eren-rudy/audio-power-amplifier/notes.txt.txt

tweeter_final_shematic.png
- replace Ri for woofer for different gain
- Include Cc and the HP filter in the feedback loop as nostuff components
