eren-rudy/audio-power-amplifier/tweeter_final_schematic.JPG

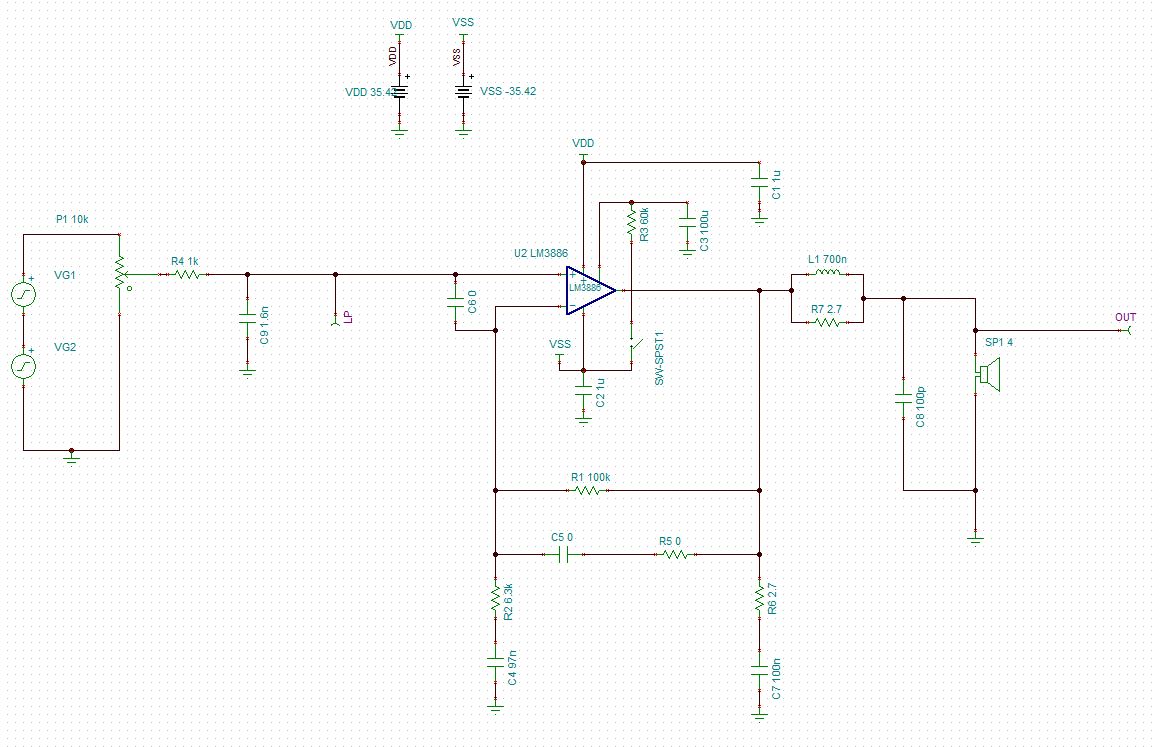
tweeter_final_schematic.JPG
