eren-rudy/audio-power-amplifier/bom_panel.xlsx

Item | MPN | DPN | Quantity | Description | Notes
Panel IO
AUX Connector
Potentiometer | EVU-F3MFL3D14 | P3F6103-ND | 3 | 10k Ohm 1 Gang Logarithmic Panel Mount Potentiometer Detent 1 Kierros 0.05W, 1/20W PC Pins, Board Locks
Power Receptacle | KM01.1205.11 | 486-2280-ND |  | Power Entry Connector Receptacle, Male Blades - Module IEC 320-C14 Panel Mount, Snap-In | 7/30 strands
Fuse
 |  |  |  |  | 4.8 mm Quick Connect
Harness |  |  |  |  | will use insulated quick connect
Audio Input wire | E2102S.41.02 | CE2102W-25-ND | 1 | 2 Conductor Multi-Conductor Cable White 22 AWG Foil 25.00' (7.62m)
Quick Connect - Female (power input) | 3-520276-2 (https://www.digikey.ca/en/products/detail/te-connectivity-amp-connectors/3-520276-2/2060928) | A99878CT-ND |  | 0.187" (4.75mm) Quick Connect Female 14-16 AWG Crimp Connector Fully Insulated | 0.8 mm thick
Quick Connect - Female (power distribution) | 4-520448-2 | A27831-ND |  | 0.250" (6.35mm) Quick Connect Female 10-12 AWG Crimp Connector Fully Insulated | 0.8mm
Ring terminals
Quick Connect - Male (power) | 1217861-1 | A100452CT-ND | 12 | 0.250" (6.35mm) Quick Connect Male Solder Connector Non-Insulated | 0.8mm
Power Distribution wire
Black | 22759/32-12-0 | 22759/32-12-0-DS-ND |  | 12 AWG Hook-Up Wire 37/28 Black 600V Enter Number of Feet in Order Quantity
White | 81044/12-12-9 | A132407-DS-ND |  | 12 AWG Hook-Up, Dual Wall Wire 37/28 White 600V Enter Number of Feet in Order Quantity
Brown | 55A0111-12-1 | 55A0111-12-1-DS-ND |  | 12 AWG Hook-Up Wire 37/28 Brown 600V Enter Number of Feet in Order Quantity
Primary side splice | 8383 | 36-8383-ND | 2 | Terminal Inline, Tap Connector IDC 14-16 to 18-20 AWG Blue
Primary side wire | 55A0111-14-9 | A132382-DS-ND |  | 14 AWG Hook-Up Wire 19/27 White 600V Enter Number of Feet in Order Quantity
Power supply
Diode heat sink | V5220L | AE10828-ND | 2 | Heat Sink TO-220 Aluminum Board Level
Misc
Standoffs
Crimping tool | CT-4071-1R (https://www.digikey.ca/en/products/detail/gc-electronics/CT-4071-1R/6616089) | CT-4071-1R-ND
heat shrink (Audio input) | V2-1.5-0-SP-SM | V2-1.5-R5-ND | 1 | Heat Shrink Tubing, Flexible 0.083" (2.11mm) 2 to 1 Black 0.042' (12.70mm, 0.50")
