eren-rudy/audio-power-amplifier/board_files/Prototype Board/Project Outputs for LM3886 Amplifier Prototype/Prototype Board V1.xlsx

Supplier Part Number 1 | Description | Designator | LibRef | Quantity
493-3209-1-ND (https://octopart-clicks.com/click/altium?sku=493-3209-1-ND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) | CAP ALUM 100UF 20% 50V SMD | C1, C4, C7 | UUQ1H101MCL1GS | 3
PCF1561CT-ND (https://octopart-clicks.com/click/altium?manufacturer=Panasonic%20Electronic%20Components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) | CAP FILM 0.1UF 5% 50VDC 1913 | C2, C5 | ECH-U1H104JX9 | 2
445-7513-1-ND (https://octopart-clicks.com/click/altium?manufacturer=TDK%20Corporation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) | CAP CER 5600PF 50V C0G 0805 | C3 | C2012C0G1H562J060AA | 1
399-14632-1-ND (https://octopart-clicks.com/click/altium?sku=399-14632-1-ND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) | CAP CER 75PF 50V NP0 0805 | C6 | C0805C750J5GAC7800 | 1
CP-3523SJCT-ND (https://octopart-clicks.com/click/altium?sku=CP-3523SJCT-ND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) | CONN JACK STEREO 3.5MM SMD R/A | J1 | SJ-3523-SMT-TR | 1
2100LL-100-V-RC-ND (https://octopart-clicks.com/click/altium?sku=2100LL-100-V-RC-ND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) | FIXED IND 10UH 11.4A 5 MOHM TH | L1 | 2100LL-100-V-RC | 1
311-6.34KDCT-ND (https://octopart-clicks.com/click/altium?sku=311-6.34KDCT-ND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) | RES SMD 6.34KOHM 0.5% 1/10W 0603 | R1 | RT0603DRD076K34L | 1
YAG2327CT-ND (https://octopart-clicks.com/click/altium?sku=YAG2327CT-ND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) | RES SMD 10K OHM 0.1% 1/8W 0805 | R2 | RT0805BRE0710KL | 1
P100KDACT-ND (https://octopart-clicks.com/click/altium?manufacturer=Panasonic%20Electronic%20Components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) | RES SMD 100K OHM 0.1% 1/8W 0805 | R3 | ERA-6AEB104V | 1
PDB181-K420K-103B-ND | POT 10K OHM 1/5W CARBON LINEAR | R4 | PDB181-K420K-103B | 1
YAG1240CT-ND (https://octopart-clicks.com/click/altium?sku=YAG1240CT-ND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) | RES SMD 1K OHM 1% 1/8W 0805 | R5 | RT0805FRE071KL | 1
RNCP0805FTD10R0CT-ND (https://octopart-clicks.com/click/altium?manufacturer=Stackpole%20Electronics%20Inc.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) | RES 10 OHM 1% 1/4W 0805 | R6 | RNCP0805FTD10R0 | 1
311-2737-1-ND (https://octopart-clicks.com/click/altium?sku=311-2737-1-ND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) | RES SMD 34.8K OHM 0.5% 1/8W 0805 | R7 | RT0805DRD0734K8L | 1
LM3886TF/NOPB-ND | IC AMP AUDIO PWR 68W AB TO220-11 | U1 | LM3886TF | 1
