eren-rudy/audio-power-amplifier/(list of files, cad)

Other CAD files:
Cabinet Sketch.SLDPRT
