eren-rudy/audio-power-amplifier/Testing.xlsx

Sheet: Validation
Validation Parameter (Dependant variable)
 | Units | Independent Variable | Units | Value | Expected Value | Measured Value
Speaker Output Voltage | Volts | Input Frequency |  | 1kHz
 |  |  |  | 5kHz
 |  |  |  | 10kHz
Speaker Output Voltage | Volts | Potentiometer position |  | 0%
 |  |  |  | 100%
Speaker Loudness | dB | Input Frequency |  | 1kHz
 |  |  |  | 5kHz
 |  |  |  | 10kHz
Mute loudness | Observed sound or none | Mute pin connection | Open/Closed | Open | None

Sheet: Waveforms
Variable | Units | Value | Notes | Waveform Number
Speaker Wire Length | Feet | 0 | Remove Inductor
 |  | 1
 |  | 3
 |  | 6
Output Inductance | Micro-Henries | 0
 |  | 10
Potentiometer Resistance | % | 0
 |  | 50
 |  | 100
Potentiometer Wire Length | Inches | 3
 |  | 12
