eren-rudy/audio-power-amplifier/sims/sim_results/0_circuit.PNG

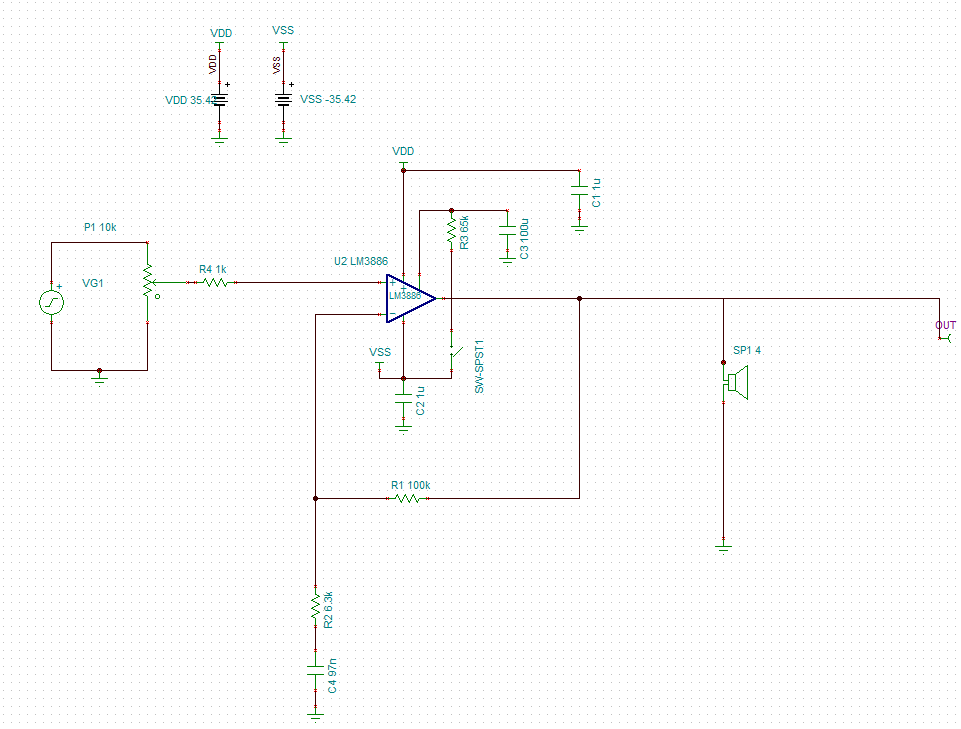
sims/sim_results/0_circuit.PNG
