eren-rudy/audio-power-amplifier/sims/sim_results/0_pm.jpg

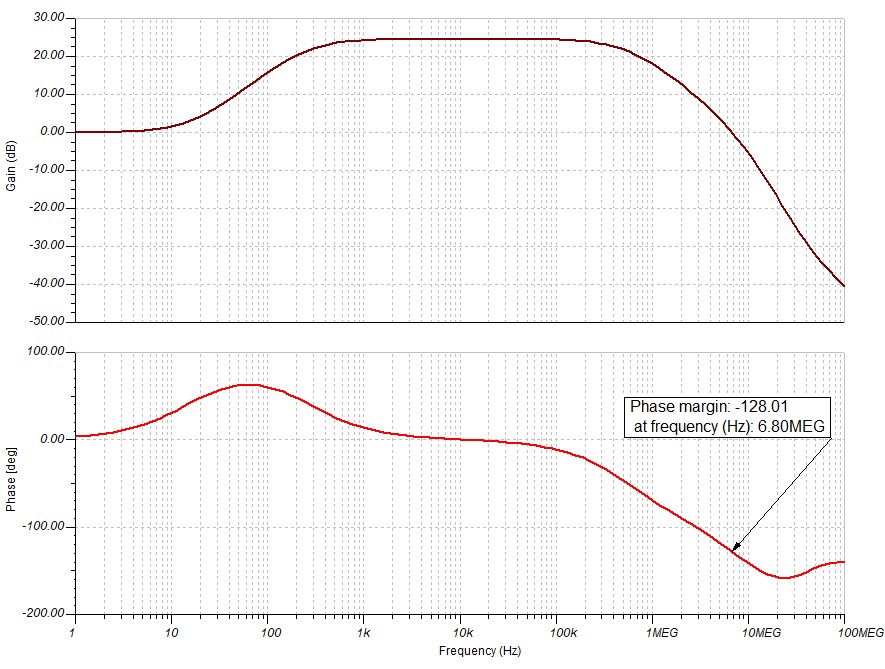
sims/sim_results/0_pm.jpg
