eren-rudy/audio-power-amplifier/sims/sim_results/1_C_only_pm.jpg

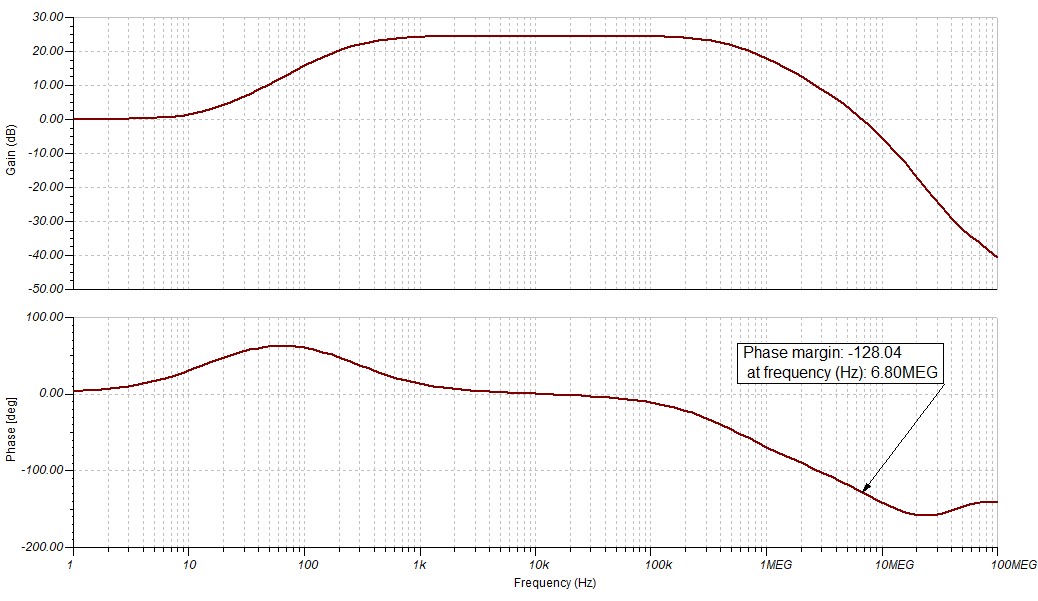
sims/sim_results/1_C_only_pm.jpg
