eren-rudy/audio-power-amplifier/sims/sim_results/1_L+C_circuit.PNG

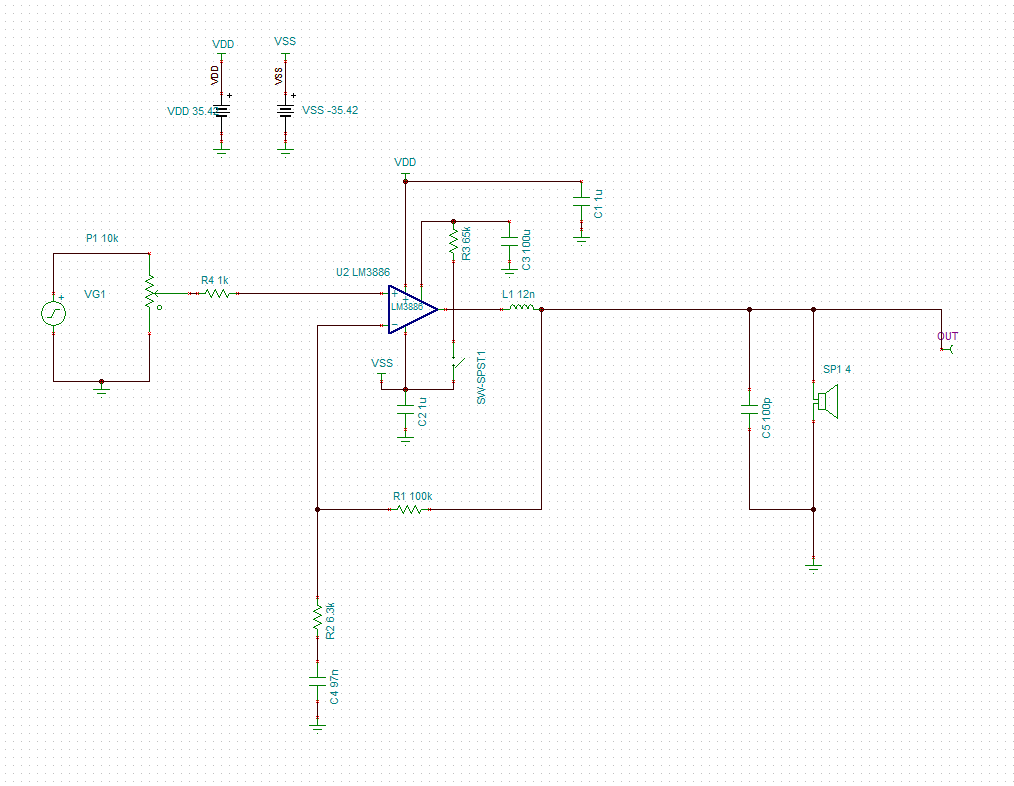
sims/sim_results/1_L+C_circuit.PNG
