eren-rudy/audio-power-amplifier/sims/sim_results/1_L+C_pm_gm.jpg

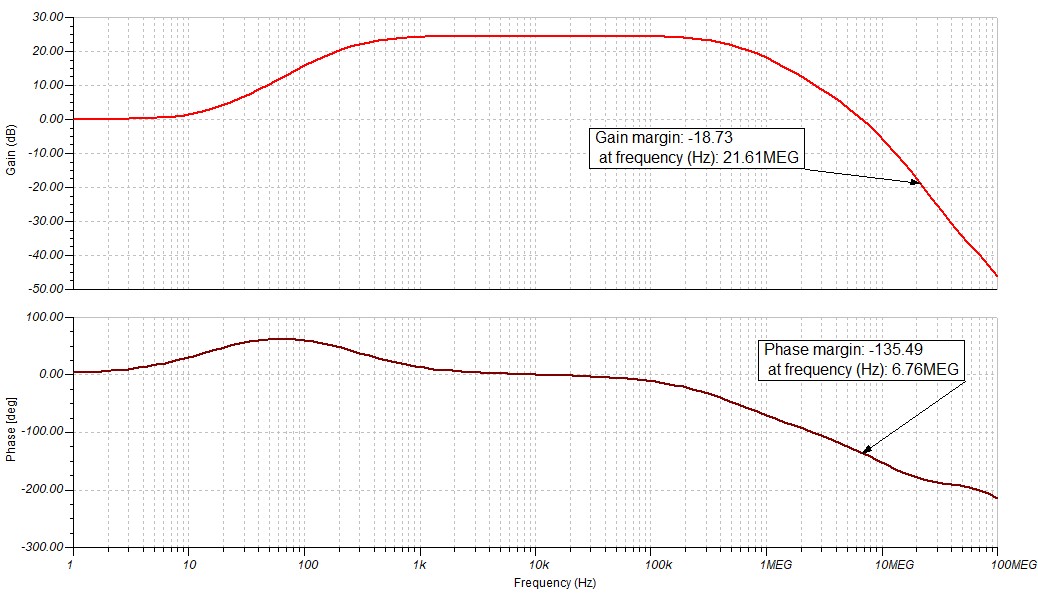
sims/sim_results/1_L+C_pm_gm.jpg
