eren-rudy/audio-power-amplifier/sims/sim_results/1_L_only_circuit.PNG

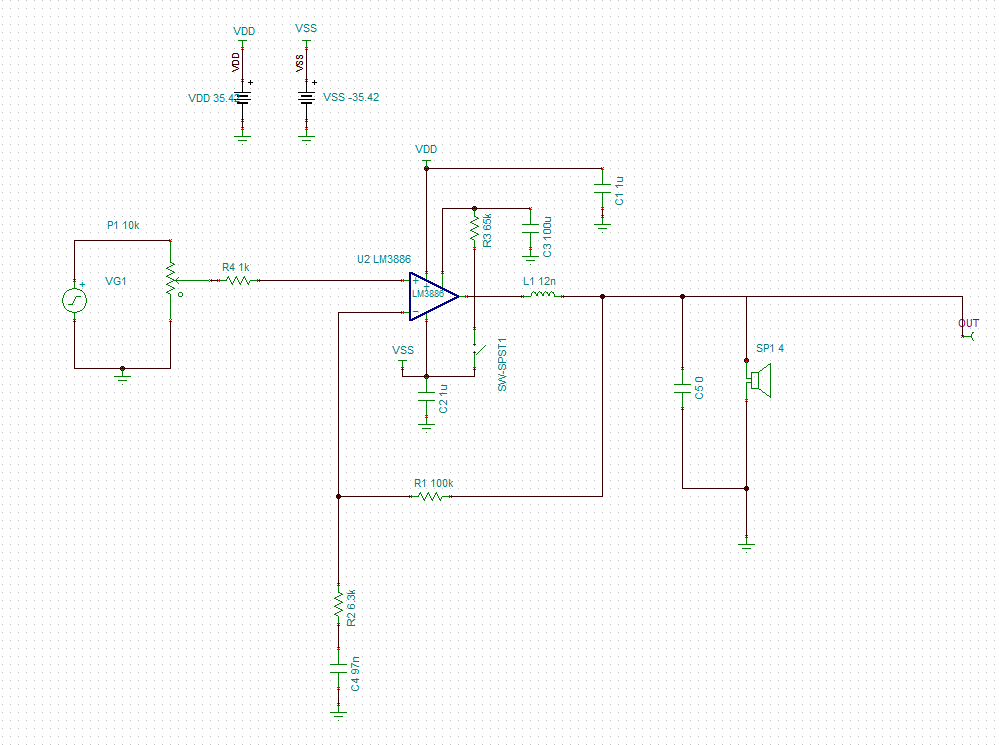
sims/sim_results/1_L_only_circuit.PNG
