eren-rudy/audio-power-amplifier/sims/sim_results/1_L_only_pm.jpg

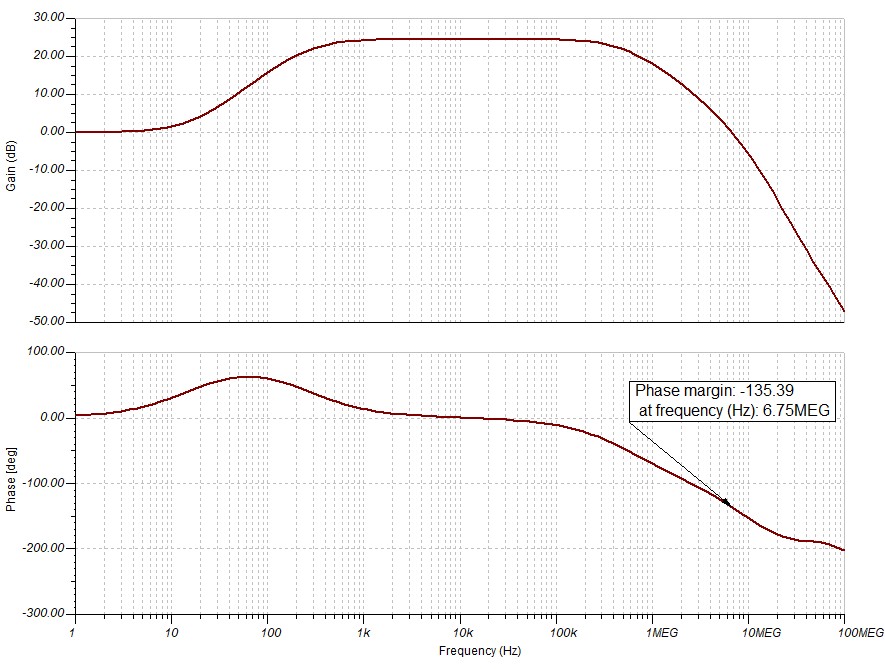
sims/sim_results/1_L_only_pm.jpg
