eren-rudy/audio-power-amplifier/sims/sim_results/2_parasitics_w_thiele_circuit.PNG

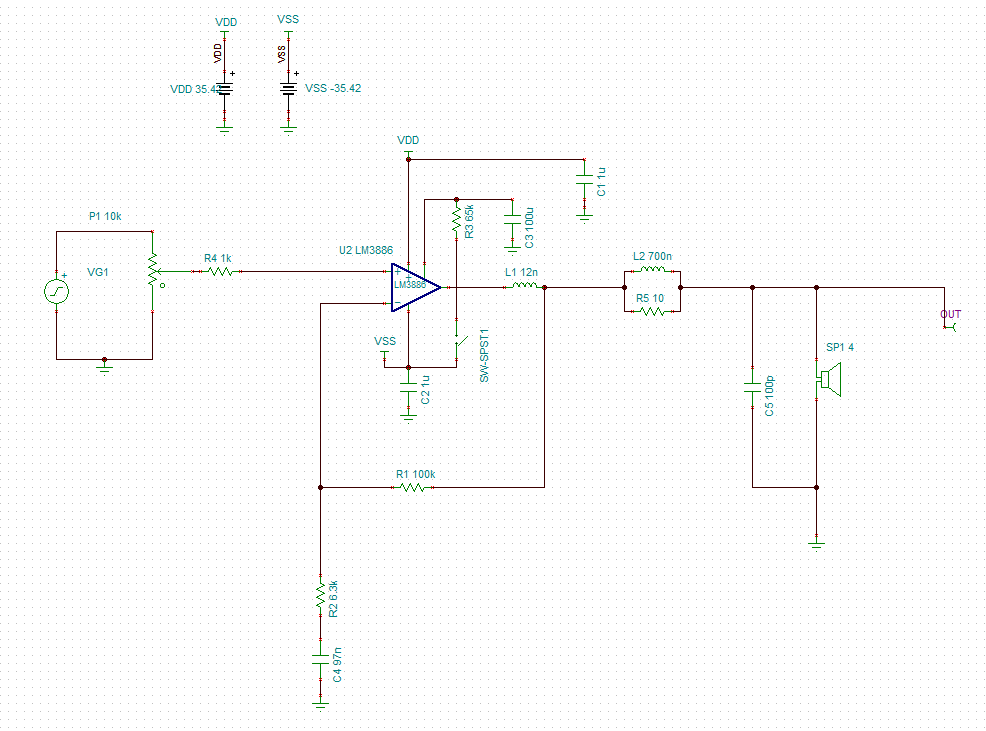
sims/sim_results/2_parasitics_w_thiele_circuit.PNG
