eren-rudy/audio-power-amplifier/sims/sim_results/2_parasitics_w_thiele_pm_gm.jpg

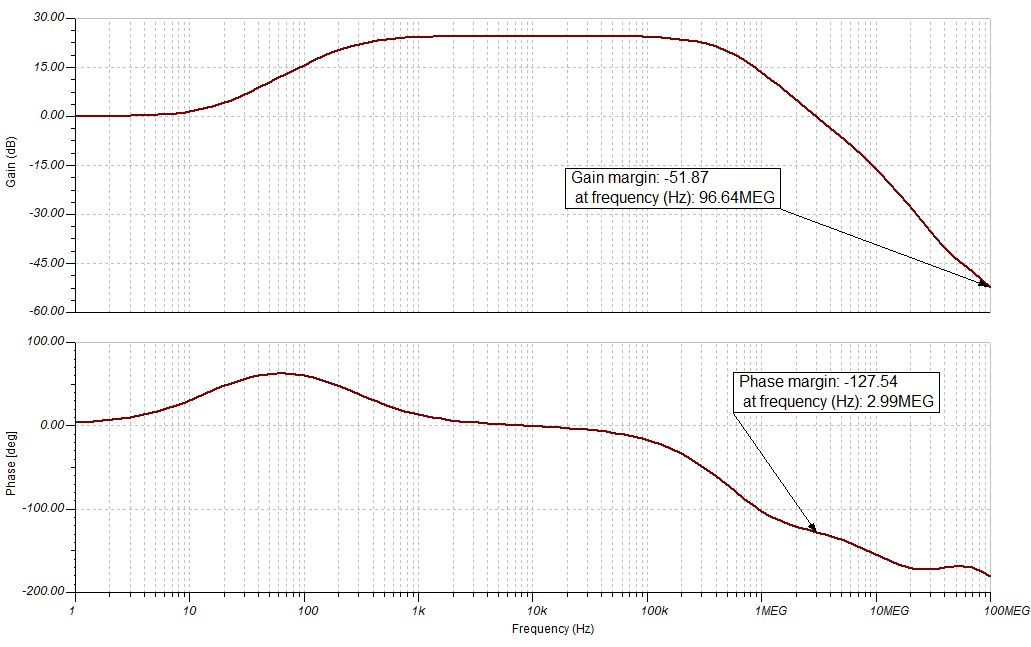
sims/sim_results/2_parasitics_w_thiele_pm_gm.jpg
