eren-rudy/audio-power-amplifier/sims/sim_results/3_parasitics_w_zobel_circuit.PNG

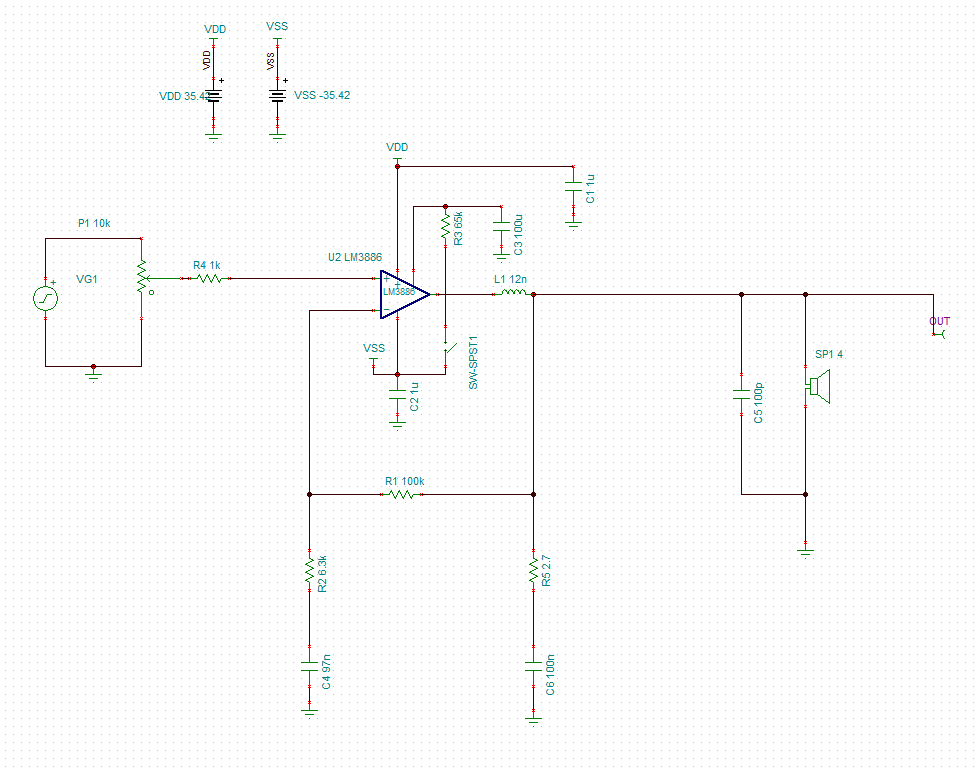
sims/sim_results/3_parasitics_w_zobel_circuit.PNG
