eren-rudy/audio-power-amplifier/sims/sim_results/3_parasitics_w_zobel_pm_gm.jpg

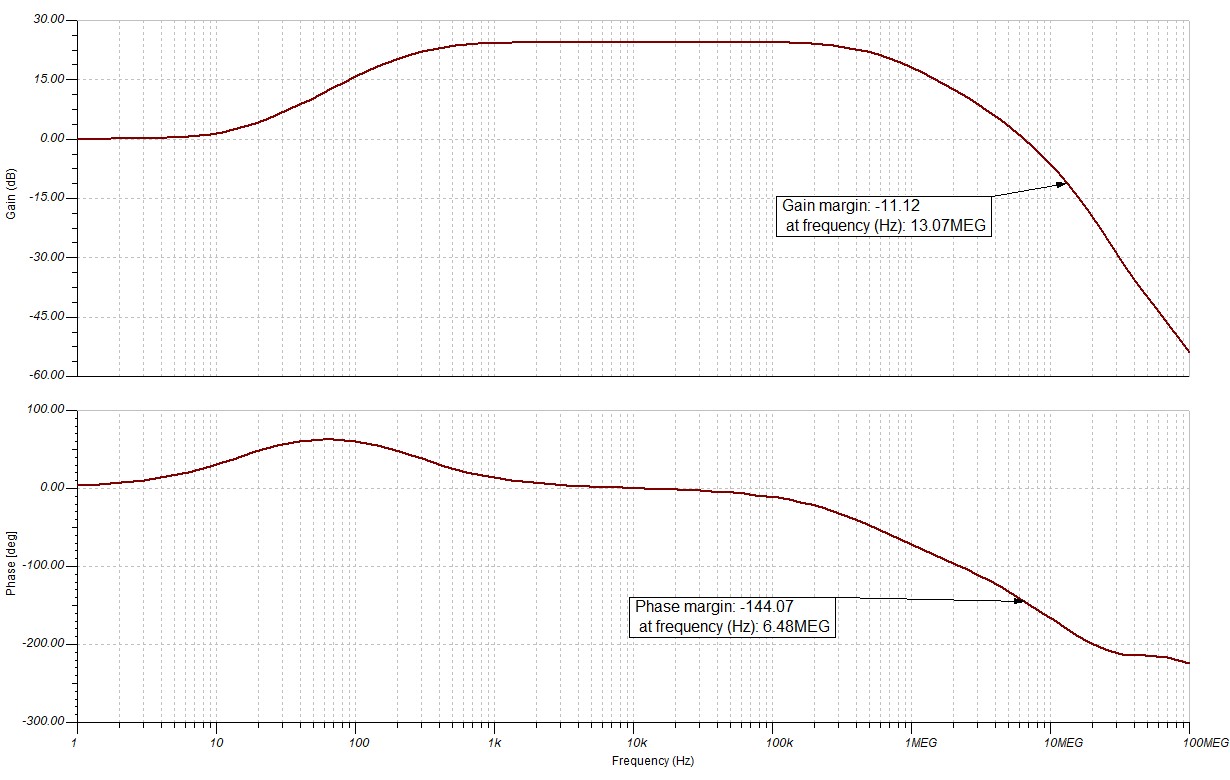
sims/sim_results/3_parasitics_w_zobel_pm_gm.jpg
