eren-rudy/audio-power-amplifier/sims/sim_results/4_parasitics_w_zobel+thiele_circuit.PNG

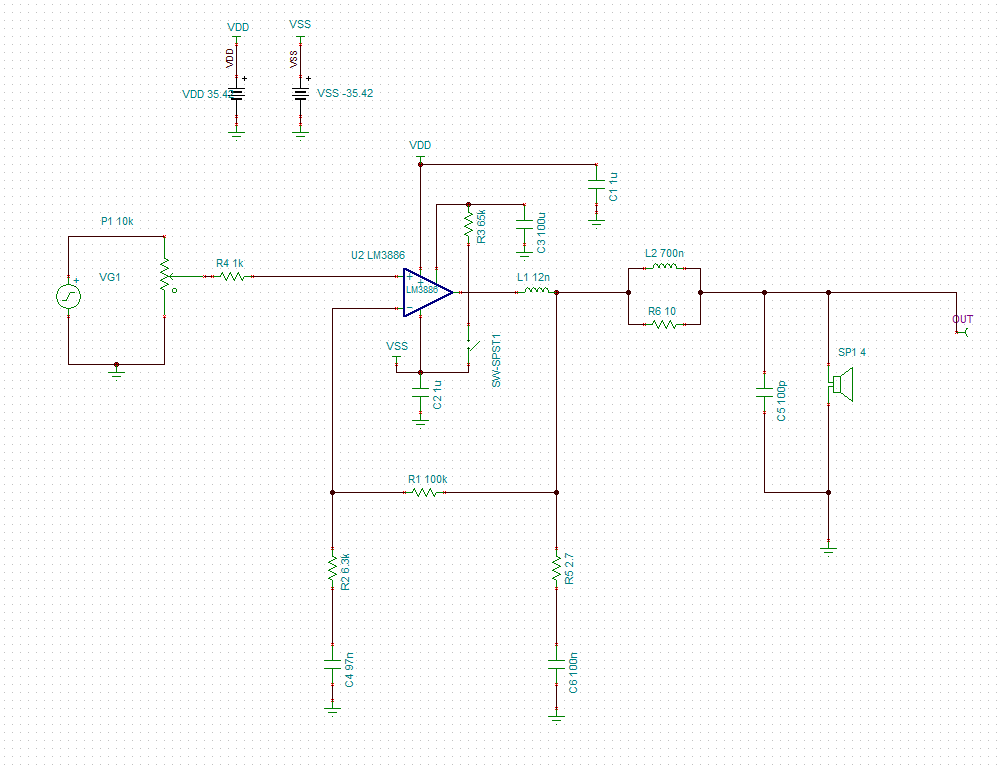
sims/sim_results/4_parasitics_w_zobel+thiele_circuit.PNG
