eren-rudy/audio-power-amplifier/sims/sim_results/4_parasitics_w_zobel+thiele_pm_gm.jpg

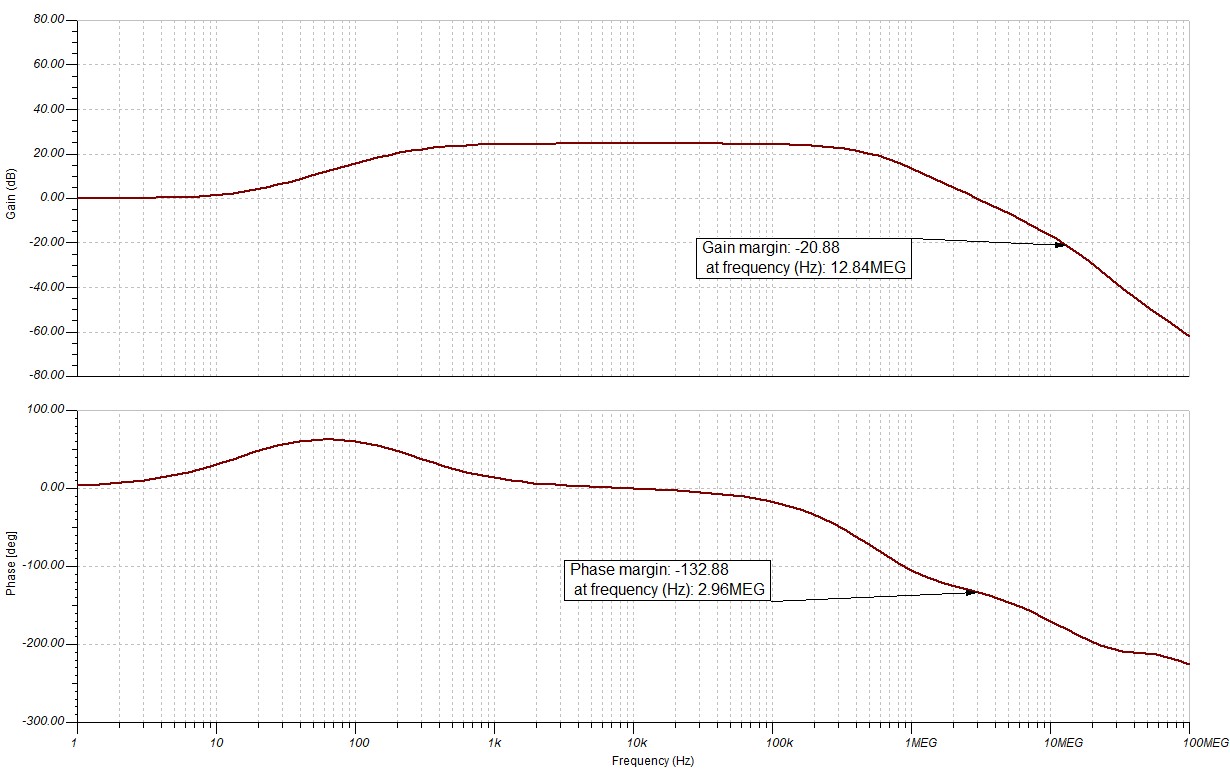
sims/sim_results/4_parasitics_w_zobel+thiele_pm_gm.jpg
