eren-rudy/audio-power-amplifier/board_files/Prototype Board/Prototype Schematic.pdf

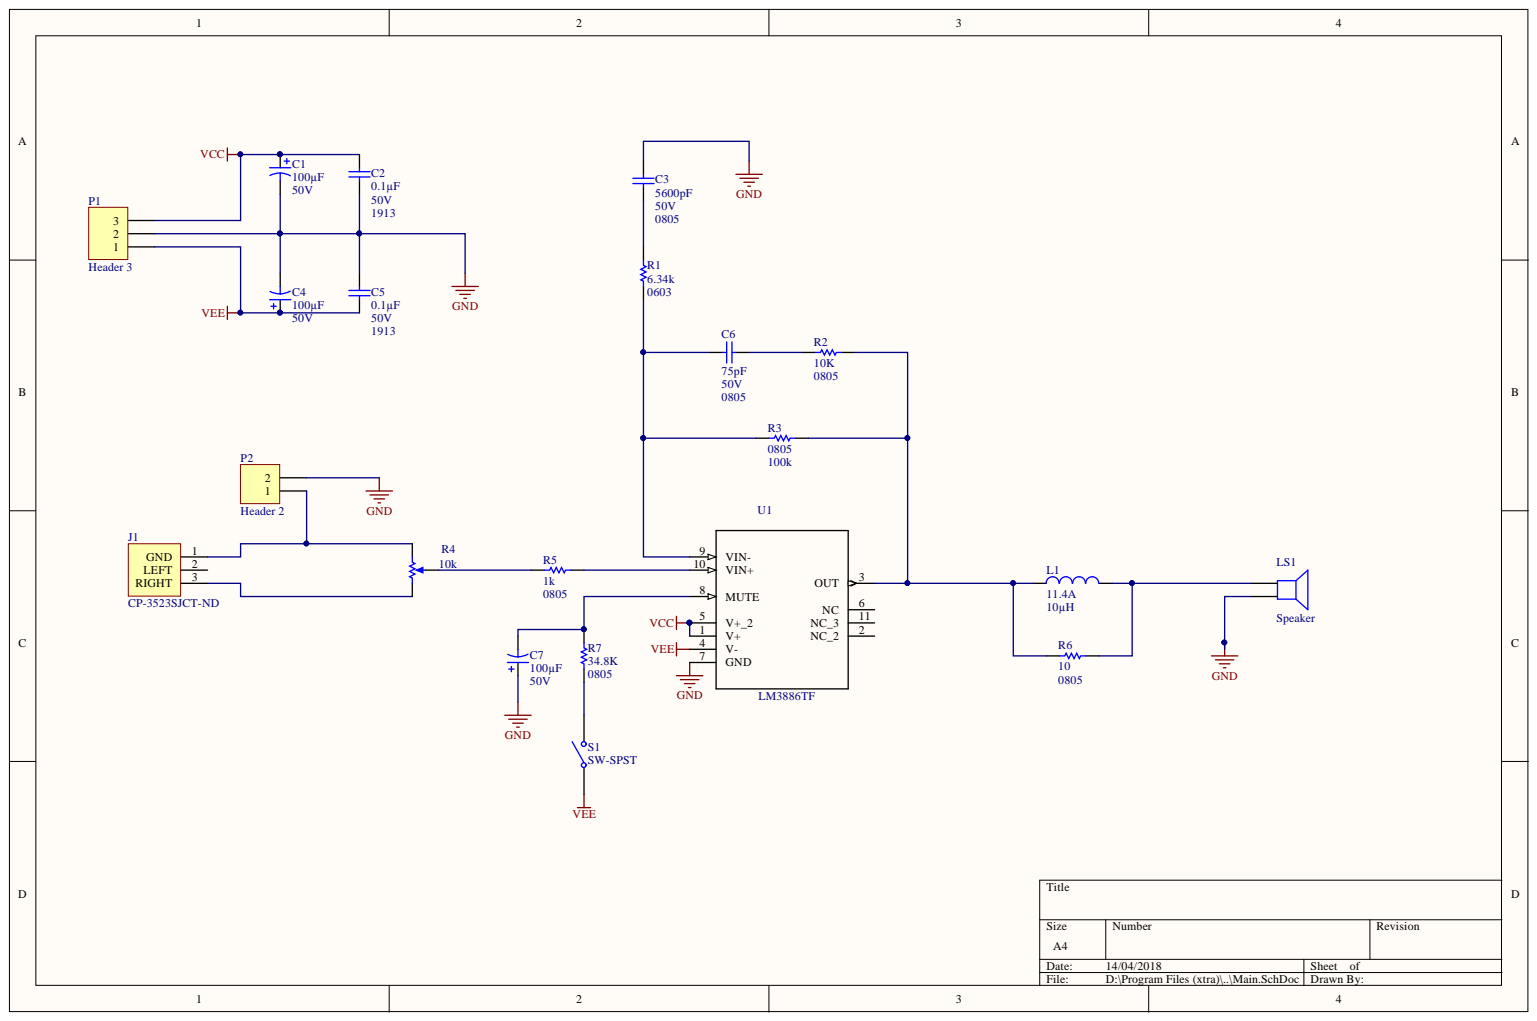
[picture p16: page 1]
