eren-rudy/audio-power-amplifier/board_files/Prototype Board/Prototype Layout.pdf

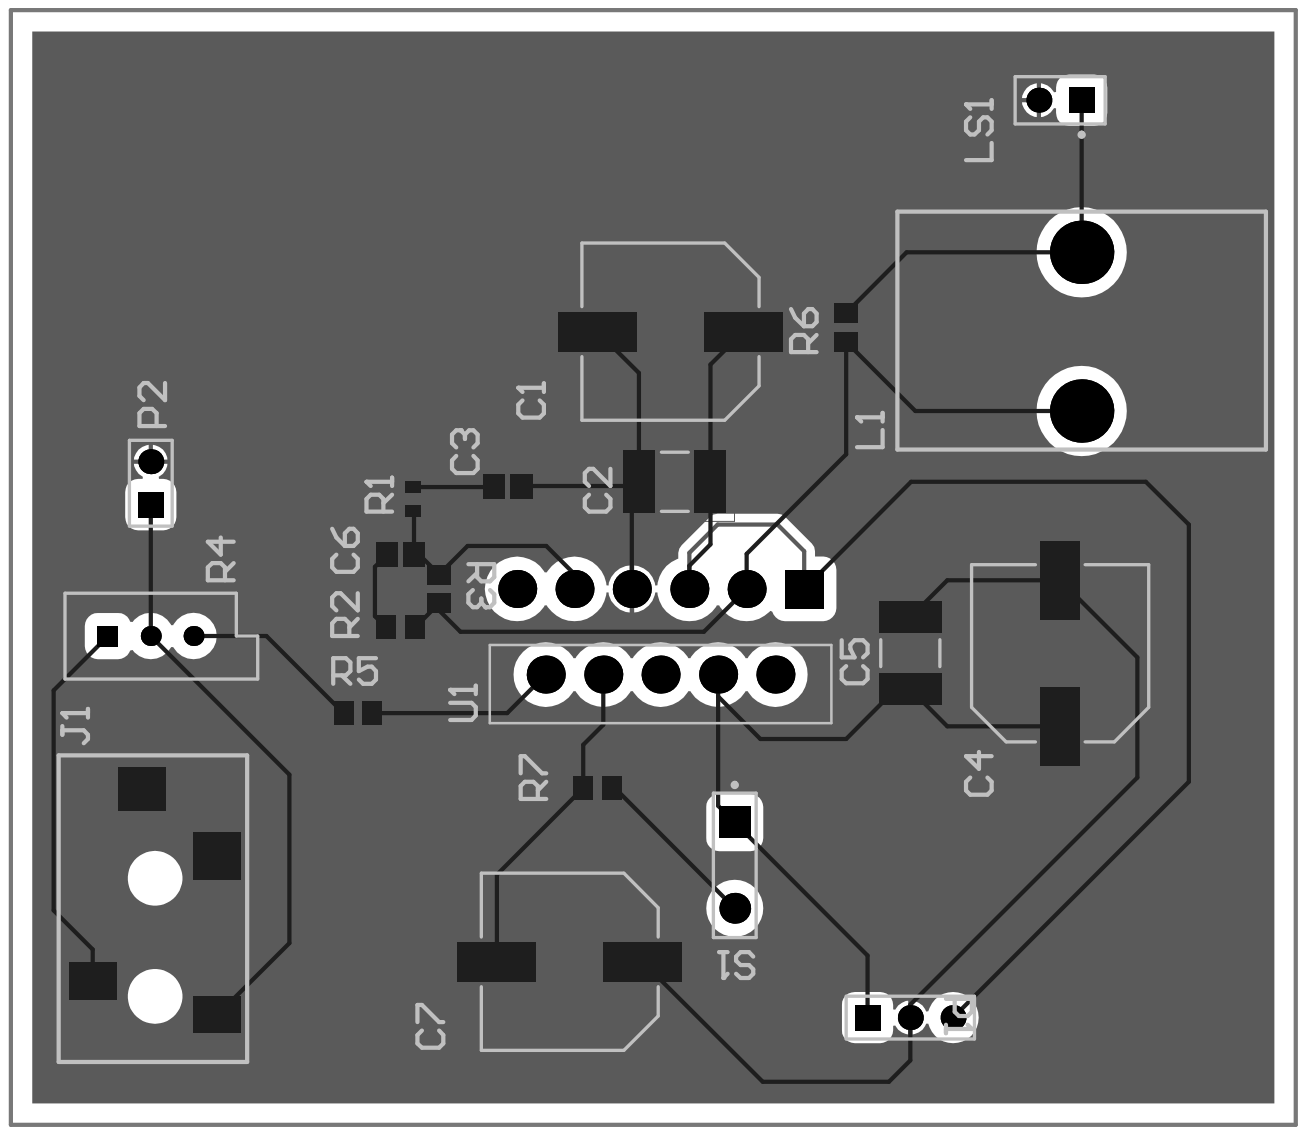
[picture p17: page 1]
