eren-rudy/audio-power-amplifier/sims/power_supply/psu_single_rectifier.asc

C1: cap; 1
C2: cap; 1
D1: diode
D2: diode
D3: diode
D4: diode
I1: current; 20
L1: ind2; 23.8; Rser=0
L2: ind2; 1; Rser=0
L3: ind2; 1; Rser=0
R1: res; 0.34
R2: res; 0.04
R3: res; 0.04
R4: res; 1Meg
R5: res; 1Meg
V1: voltage; SINE(0 169.7 60); Rser=0
Named nets: 0, V+, V-, V2
K1 L1 L2 L3 1
.tran 1
