eren-rudy/audio-power-amplifier/sims/power_supply/psu_centre_tap_gnd.asc

C1: cap; 1
C2: cap; 1
D1: diode
D2: diode
D3: diode
D4: diode
I1: current; 1
L1: ind2; 23.8; Rser=0
L2: ind2; 1; Rser=0
L3: ind2; 1; Rser=0
R1: res; 0.34
R2: res; 0.04
R3: res; 0.04
V1: voltage; SINE(0 169.7 60); Rser=0
Named nets: 0, V+, V2, V-
K1 L1 L2 L3 1
.tran 1
