eren-rudy/audio-power-amplifier/sims/power_supply/psu_wrong.asc

C1: cap; 1
C2: cap; 1
D1: diode
D2: diode
D3: diode
D4: diode
D5: diode
D6: diode
D7: diode
D8: diode
I1: load; 20
L1: ind2; 23.8; Rser=0.0001
L2: ind2; 1; Rser=0.0001
L3: ind2; 1; Rser=0.0001
V1: voltage; SINE(0 169.7 60); Rser=0
Named nets: 0, V+, V-, V2
K1 L1 L2 L3 1
.tran 2
