eren-rudy/audio-power-amplifier/sims/power_supply/transformer_resonant_circuit.asc

C1: cap; 1µ
I1: current; PULSE(10A 0 0.1 0 1n 0 0.1 3)
L3: ind; 1m
R1: res; 1
V1: voltage; 170; Rser=0
Named nets: 0
.tran 0.5
