eren-rudy/audio-power-amplifier/(list of files, drawings)

Other design files:
board_files/4 Channel Power Amplifier/4 Channel Power Amplifier.PrjPcb
board_files/4 Channel Power Amplifier/Tweeter Right.SchDoc
board_files/Integrated_Libraries/Aluminum Electrolytic Caps.PcbLib
board_files/Integrated_Libraries/Capacitors.SchLib
board_files/Integrated_Libraries/Chip Footprints.PcbLib
board_files/Integrated_Libraries/Inductors.PcbLib
board_files/Integrated_Libraries/Inductors.SchLib
board_files/Integrated_Libraries/Mechanical_Devices.PcbLib
board_files/Integrated_Libraries/Mechanical_Devices.SchLib
board_files/Integrated_Libraries/Resistors.SchLib
board_files/LM3886TF/Imported LM3886TF.lia/LM3886TF.PcbLib
board_files/LM3886TF/Imported LM3886TF.lia/LM3886TF.SchLib
board_files/Prototype Board/LM3886 Amplifier Prototype.PrjPcb
board_files/Prototype Board/Main.SchDoc
board_files/Prototype Board/Prototype Board V1.PcbDoc
