eren-rudy/audio-power-amplifier/board_files/power_supply/power_supply.kicad_pcb

## KiCad design board_files/power_supply/power_supply.kicad_pcb (2020-07-10)

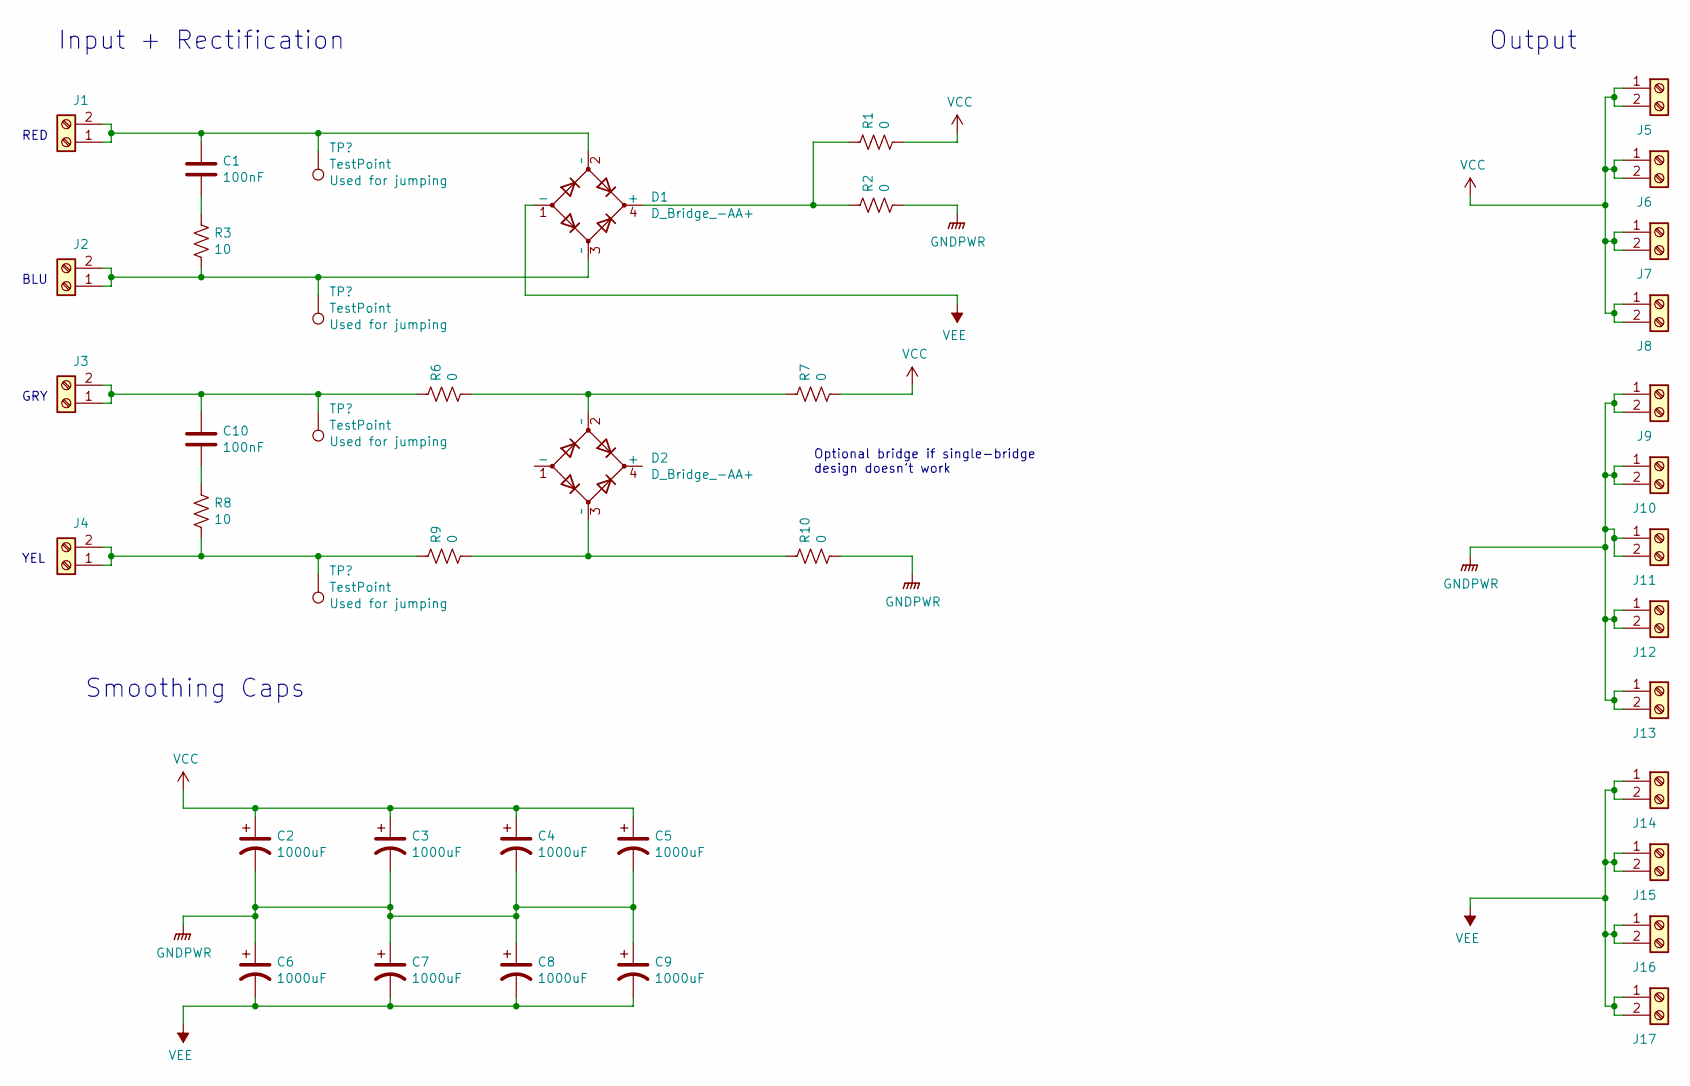
[picture p18: schematic power_supply.sch]

Parts:
C1, C10: 100nF; C_1206_3216Metric; MPN 885012208118; Digikey PN 732-12245-1-ND
C2, C3, C4, C5, C6, C7, C8, C9: 1000uF; CP_Radial_D12.5mm_P5.00mm; MPN ECA-1HM102B; Digikey PN P19529CT-ND
D1, D2: D_Bridge_-AA+; Diode_Bridge_32.0x5.6x17.0mm_P10.0mm_P7.5mm; MPN GBJ2508-BP; Digikey PN GBJ2508-BPMS-ND
J1, J2, J3, J4, J5, J6, J7, J8, J9, J10, J11, J12, J13, J14, J15, J16, J17: Screw_Terminal_01x02; TE_QC_250_Male_Blade_P5.08; MPN 1217861-1; Digikey PN A100452CT-ND
R1, R2, R6, R7, R9, R10: 0; 12_Gauge_Jumper
R3, R8: 10; R_Axial_DIN0207_L6.3mm_D2.5mm_P7.62mm_Horizontal; MPN FMP100JR-52-10R; Digikey PN 10WCT-ND

Connections:
GNDPWR: C2.2, C3.2, C4.2, C5.2, C6.1, C7.1, C8.1, C9.1, J9.1, J9.2, J10.1, J10.2, J11.1, J11.2, J12.1, J12.2, J13.1, J13.2, R2.2, R10.2
unnamed 1: C1.1, D1.2 (~~), J1.1, J1.2; also elsewhere on the board
unnamed: C1.2, R3.1
unnamed 3: C10.1, J3.1, J3.2, R6.1; also elsewhere on the board
unnamed: C10.2, R8.1
unnamed 5: D1.3 (~~), J2.1, J2.2, R3.2; also elsewhere on the board
unnamed: D1.4 (+), R1.1, R2.1
unnamed: D2.2 (~~), R6.2, R7.1
unnamed: D2.3 (~~), R9.2, R10.1
unnamed 11: J4.1, J4.2, R8.2, R9.1; also elsewhere on the board
VCC: C2.1, C3.1, C4.1, C5.1, J5.1, J5.2, J6.1, J6.2, J7.1, J7.2, J8.1, J8.2, R1.2, R7.2
VEE: C6.2, C7.2, C8.2, C9.2, D1.1 (-), J14.1, J14.2, J15.1, J15.2, J16.1, J16.2, J17.1, J17.2

Notes on the sheet:
RED
BLU
GRY
YEL
Optional bridge if single-bridge design doesn’t work
Input + Rectification
Smoothing Caps
Output

Board: 2 copper layers, 41 parts (0 on the bottom side), 12 nets, no tracks yet.

Other parts of the board:
TP1, TP2, TP3, TP4: TestPoint; 12_Gauge_Jumper_one_pad

Their connections:
unnamed 1: TP1.1; also elsewhere on the board
unnamed 3: TP3.1; also elsewhere on the board
unnamed 5: TP2.1; also elsewhere on the board
unnamed 11: TP4.1; also elsewhere on the board
