eren-rudy/audio-power-amplifier/board_files/one_channel_amplifier/one_channel_amplifier.kicad_pcb

## KiCad design board_files/one_channel_amplifier/one_channel_amplifier.kicad_pcb (2020-07-05)

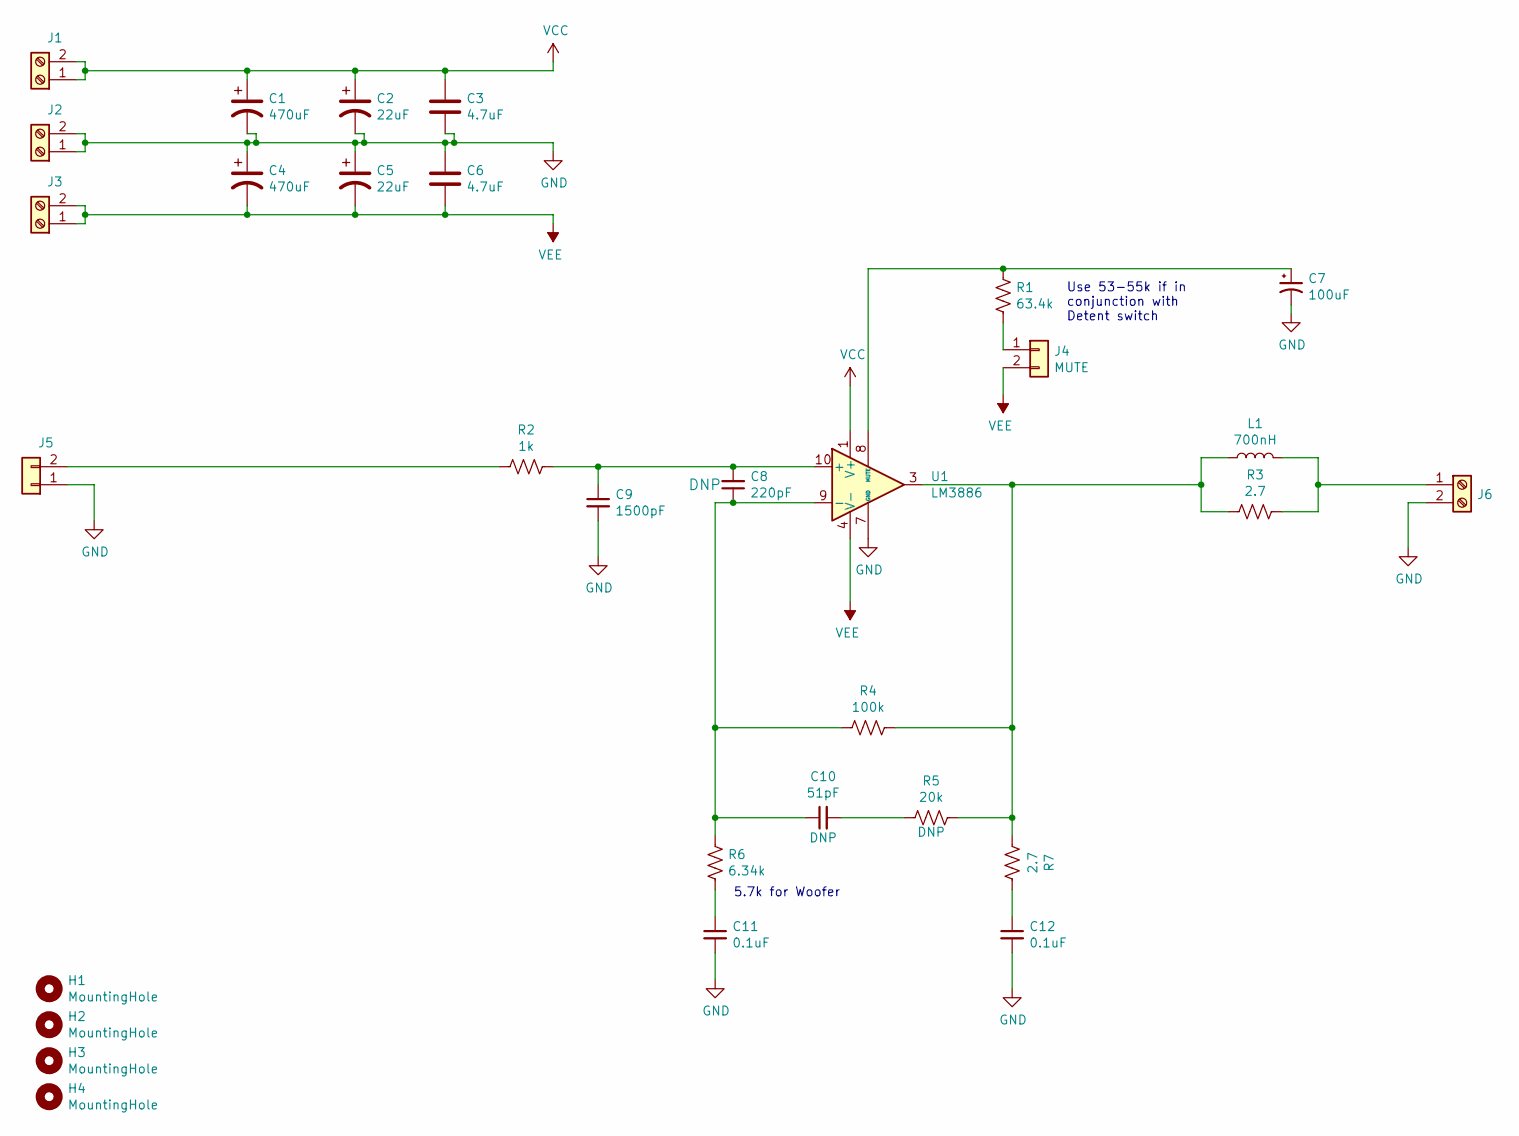
[picture p19: schematic one_channel_amplifier.sch]

Parts:
C1, C4: 470uF; CP_Radial_D16.0mm_P7.50mm; MPN ECA-2AHG471B
C2, C5: 22uF; CP_Radial_D10.0mm_P5.00mm; MPN 100SXE22M
C3, C6: 4.7uF; R_1210_3225Metric; MPN CL32B475KCVZW6E
C7: 100uF; CP_Radial_D8.0mm_P3.50mm; MPN ECA-1HM101
C8: 220pF; C_0603_1608Metric; MPN C0603C221K1RACTU; Digikey PN 399-7877-1-ND
C9: 1500pF; C_0603_1608Metric; MPN GRM188R72A152KA01D; Digikey PN 490-1475-1-ND
C10: 51pF; C_0603_1608Metric; MPN CL10C510JB8NNNC
C11, C12: 0.1uF; C_0603_1608Metric; MPN CC0603KRX7R0BB104
H1, H2, H3, H4: MountingHole; MountingHole_3.2mm_M3
J1, J2, J3: Screw_Terminal_01x02; TE_QC_250_Male_Blade_P5.08; MPN 1217861-1; Digikey PN A100452CT-ND
J4, J5: Conn_01x02; PinHeader_1x02_P2.54mm_Vertical
J6: Screw_Terminal_01x02; TerminalBlock_bornier-2_P5.08mm; MPN EB147A-02-D; Digikey PN 2057-EB147A-02-D-ND
L1: PA0277NL; MPN PA0277NL
R1: 63.4k; R_0603_1608Metric; MPN ERJ-3EKF6342V
R2: 1k; R_0603_1608Metric; MPN RC0603FR-071KL; Digikey PN 311-1.00KHRCT-ND
R3, R7: 2.7; R_0603_1608Metric; MPN RK73H1JTTD2R70F; Digikey PN 2019-RK73H1JTTD2R70FCT-ND
R4: 100k; R_0603_1608Metric; MPN RMCF0603FT100K
R5: 20k; R_0603_1608Metric; MPN ERJ-3EKF2002V
R6: 6.34k; R_0603_1608Metric; MPN ERJ-6ENF6341V
U1: LM3886; TO-220F-11_P3.4x5.08mm_StaggerOdd_Lead5.08mm_Vertical; MPN LM3886T/NOPB

Connections:
GND: C1.2, C2.2, C3.2, C4.1, C5.1, C6.1, C7.2, C9.2, C11.2, C12.2, J2.1, J2.2, J5.1, J6.2, U1.7 (GND)
unnamed: C7.1, R1.1, U1.8 (MUTE)
unnamed: C8.2, C9.1, R2.1, U1.10 (+)
unnamed: C8.1, C10.1, R4.2, R6.1, U1.9 (-)
unnamed: C10.2, R5.2
unnamed: C11.1, R6.2
unnamed: C12.1, R7.2
unnamed: J4.1, R1.2
unnamed: J5.2, R2.2
unnamed: J6.1, L1.2, R3.2
unnamed: L1.1, R3.1, R4.1, R5.1, R7.1, U1.3
VCC: C1.1, C2.1, C3.1, J1.1, J1.2, U1.1 (V+), U1.5 (V+)
VEE: C4.2, C5.2, C6.2, J3.1, J3.2, J4.2, U1.4 (V-)

Notes on the sheet:
5.7k for Woofer
Use 53-55k if in conjunction with Detent switch

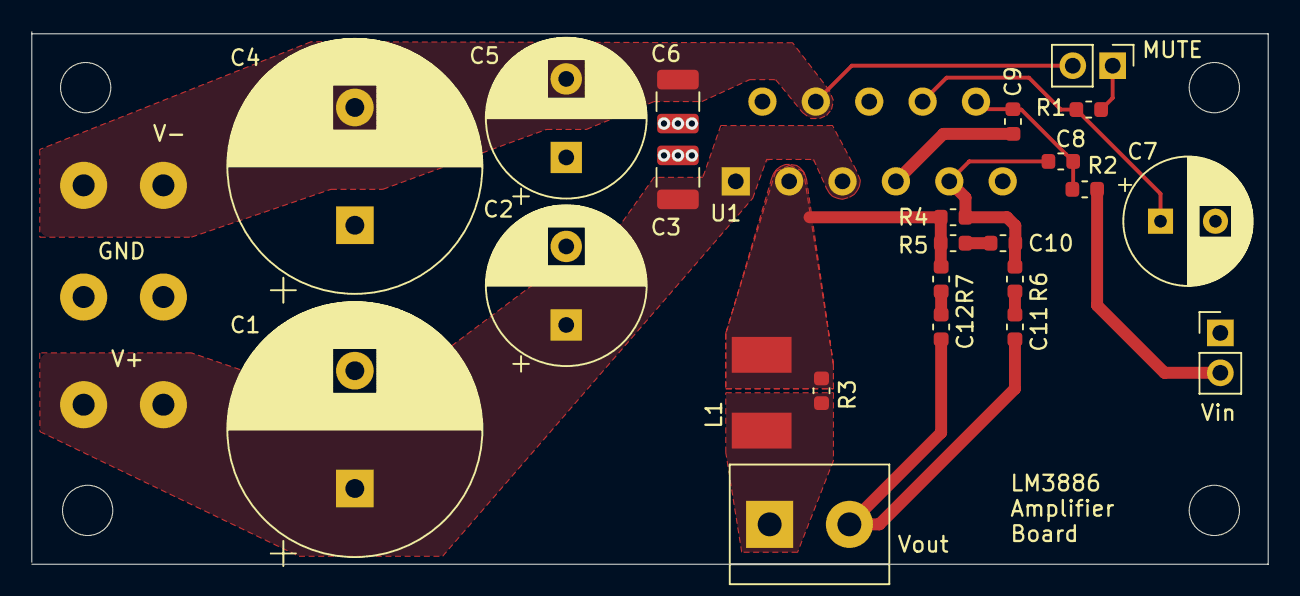
[picture p20: board one_channel_amplifier.kicad_pcb from above]

Board: 2 copper layers, 78.7 x 33.9 mm, 31 parts (0 on the bottom side), 13 nets.
