eren-rudy/audio-power-amplifier/(commit log)

2018-02-22 Added low-pass filter simulation
    [Calculations.xlsx]
2018-02-22 Added SPL calculations
    [Calculations.xlsx]
2018-03-11 addded working spice model
    [Calculations.xlsx]
2018-03-17 Added power simulation and calculations
    [Calculations.xlsx]
2018-03-27 Added Altium PCB project and libraries
    [Calculations.xlsx, LM3886 Amplifier Prototype.PrjPcb, LM3886TF.PcbLib, LM3886TF.SchLib, Main.SchDoc, Symbols.SchLib]
2018-03-29 Added simulation and calculations for low pass filter
    [Calculations.xlsx, Main.SchDoc]
2018-04-04 Added resistors to library
    [Calculations.xlsx, Chip Footprints.PcbLib, Main.SchDoc, Resistors.SchLib, Symbols.SchLib]
2018-04-06 Added capacitor library
    [Aluminum Electrolytic Caps.PcbLib, Capacitors.SchLib, Chip Footprints.PcbLib]
2018-04-07 Added inductor
    [Calculations.xlsx, Capacitors.SchLib, Inductors.PcbLib, Inductors.SchLib]
2018-04-07 Added 3.5mm connector
    [Calculations.xlsx, Capacitors.SchLib, Inductors.PcbLib, Main.SchDoc, Mechanical_Devices.PcbLib, Mechanical_Devices.SchLib]
2018-04-08 Added Altium schematic
    [Capacitors.SchLib, Chip Footprints.PcbLib, LM3886 Amplifier Prototype.PrjPcb, Main.SchDoc, Resistors.SchLib]
2018-04-08 Finished prototype PCB design
    [Calculations.xlsx, Chip Footprints.PcbLib, LM3886 Amplifier Prototype.PrjPcb, Main.SchDoc, Prototype Board V1.PcbDoc, Resistors.SchLib]
2018-04-09 Added BOM
    [LM3886 Amplifier Prototype.PrjPcb, Main.SchDoc, Prototype Board V1.PcbDoc, Prototype Board V1.xlsx]
2018-04-10 Created Gerber X2 outputs
    [LM3886 Amplifier Prototype.PrjPcb, Main.SchDoc, Prototype Board V1.PcbDoc, Prototype Board V1.xlsx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]
2018-04-14 Added PDF of schematic
    [LM3886 Amplifier Prototype.PrjPcb, Prototype Board V1.PcbDoc]
2018-04-14 Added schematic PDF
    [LM3886 Amplifier Prototype.PrjPcb]
2018-04-20 Adjusted Tweeter design
    [Calculations.xlsx]
2018-04-21 Added spreadsheet for test cases
    [4 Channel Power Amplifier.PrjPcb, Calculations.xlsx, LM3886 Amplifier Prototype.PrjPcb, Main.SchDoc, Prototype Board V1.PcbDoc, Prototype Board V1.xlsx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]
2018-04-25 Added sketch of cabinet in SW
    [4 Channel Power Amplifier.PrjPcb, Cabinet Sketch.SLDPRT, Tweeter Right.SchDoc]
2020-05-26 Added initial simulations and screenshots for ideal vs. non-ideal case
2020-05-28 Added folder for simulation results
    [Calculations.xlsx]
2020-06-04 Added total ideal sim and stability sim
    [Calculations.xlsx]
2020-06-04 fixed old transformer sim
    [Calculations.xlsx]
2020-06-05 Fixed psu model, added model for diode resonance
    [4 Channel Power Amplifier.PrjPcb, Aluminum Electrolytic Caps.PcbLib, Capacitors.SchLib, Chip Footprints.PcbLib, Inductors.PcbLib, Inductors.SchLib, LM3886 Amplifier Prototype.PrjPcb, LM3886TF.PcbLib]
2020-06-06 added psu circuit with parasitics
2020-06-08 added screenshot of final amplifier schematic
2020-06-09 added kicad project for amplifier board
    [Calculations.xlsx, one_channel_amplifier.kicad_pcb, one_channel_amplifier.sch]
2020-06-10 added potentiometer to schematic
    [one_channel_amplifier.sch]
2020-06-11 added thiele network
    [Calculations.xlsx, one_channel_amplifier.sch]
2020-06-12 more schematic progress
    [one_channel_amplifier.sch]
2020-06-13 finished bypass caps
    [bom_panel.xlsx, one_channel_amplifier.sch]
2020-06-14 finished adding components
    [one_channel_amplifier.sch]
2020-06-15 finished schematic, started panel BOM
    [Calculations.xlsx, bom_panel.xlsx, one_channel_amplifier.sch]
2020-06-16 Finalized sch and exported to layout
    [bom_panel.xlsx, one_channel_amplifier.kicad_pcb, one_channel_amplifier.sch]
2020-06-17 Changed power input to use quick connect plugs
    [bom_panel.xlsx, one_channel_amplifier.sch]
2020-06-18 Initial component placement process
    [bom_panel.xlsx, one_channel_amplifier.kicad_pcb]
2020-06-21 completed component placement
    [bom_panel.xlsx, design2.kicad_pcb]
2020-06-22 added 3rd design iteration
    [bom_panel.xlsx, design2.kicad_pcb, design3.kicad_pcb]
2020-06-23 added power planes
    [design3.kicad_pcb]
2020-06-25 removed other PCB designs
    [design2.kicad_pcb, design3.kicad_pcb, one_channel_amplifier.kicad_pcb]
2020-06-25 removed silkscreen from U1
    [one_channel_amplifier.sch]
2020-06-26 Finished first rev
    [one_channel_amplifier.kicad_pcb]
2020-06-27 Added mounting holes to amplifier PCB
    [bom_panel.xlsx, one_channel_amplifier.kicad_pcb, one_channel_amplifier.sch, power_supply.kicad_pcb, power_supply.sch]
2020-06-30 Added bridge rectifiers
    [bom_panel.xlsx, power_supply.sch]
2020-07-03 Finished adding components to PSU schematic, started wiring
    [power_supply.sch]
2020-07-05 finished psu schematic and added front panel
    [one_channel_amplifier.kicad_pcb, power_supply.kicad_pcb, power_supply.sch]
2020-07-08 Started PSU layout + panel
    [power_supply.kicad_pcb]
2020-07-10 rough component placement
    [power_supply.kicad_pcb, power_supply.sch]
